chipmunk-tail/2020_SensorEngineering_Project/(commit log)

2025-02-19 2020 MicroProcesser arduino add
2025-02-19 2020 sensor engineering arduino
